physical-intuition/kimi-chip/dataflow/x3y5_timing/reports_final/cts_default_core_clock_layout.webp

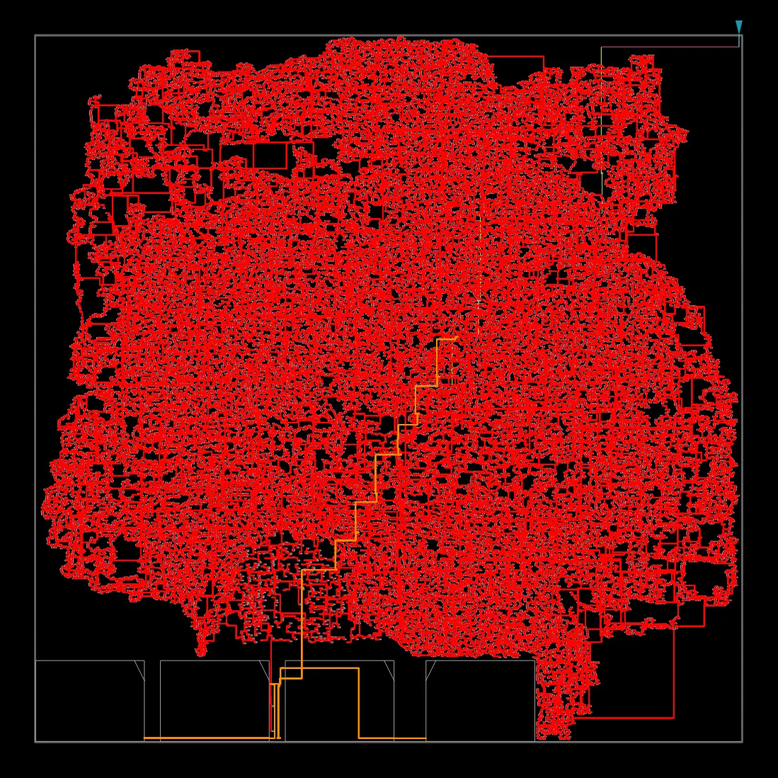
dataflow/x3y5_timing/reports_final/cts_default_core_clock_layout.webp
