physical-intuition/kimi-chip/dataflow/x3y5_timing/reports_final/final_resizer.webp

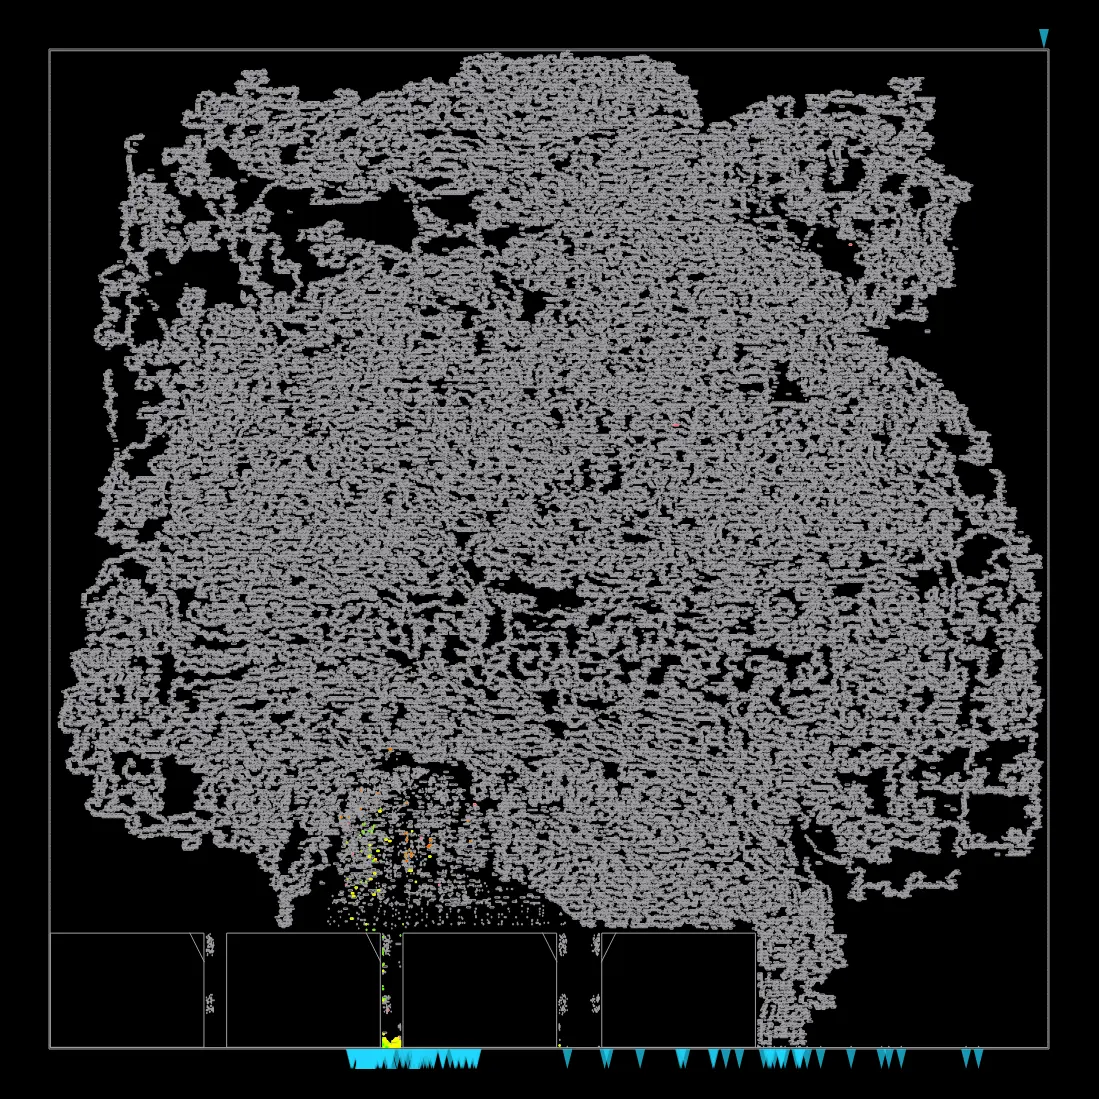
dataflow/x3y5_timing/reports_final/final_resizer.webp
