physical-intuition/kimi-chip/EXPERIMENTS.md

# kimi-chip-fresh dataflow experiment log

repo: github.com/physical-intuition/kimi-chip
flow: openroad/orfs:latest, nangate45, top = dataflow_top
dims (toy): D_MODEL=32, KDA 2x16, MLA dk16 dr8 dv16 dc32, MAX_SEQ=16, CONV_KERNEL=4, N_LAYERS=2
dims (real/nano-kpu): D_MODEL=64, KDA 2x32, MLA dc=128, MAX_SEQ=64

## X1: FSM skeleton (constraint sweep)
| variant | change | period (ns) | fmax (GHz) | setup ws (ns) | viol | area (um2) | power (mW) | commit |
|---|---|---|---|---|---|---|---|---|
| X1Y1 | FSM skeleton, all phases cycle-counting | 1.0 | 2.294 | - | 0 | ~591 | ~1.0 | 4ee46f1 |
| X1Y2 | constraint tighten | 0.8 | 2.289 | 0.363 | 0 | 591.1 | 1.08 | 618b87a |
| X1Y3 | constraint tighten | 0.6 | 2.317 | 0.168 | 0 | 591.9 | 1.42 | 2a0e823 |
| X1Y4 | constraint tighten | 0.5 | 2.295 | 0.064 | 0 | 592.6 | 1.71 | 9ede9e6 |
| X1Y5 | constraint tighten | 0.48 | 2.347 | 0.054 | 0 | 594.2 | 1.80 | 8a6d8e4 |

## X2: Add real compute (MAC + SRAM)
| variant | change | period (ns) | fmax (GHz) | setup ws (ns) | viol | area (um2) | power (mW) | commit |
|---|---|---|---|---|---|---|---|---|
| X2Y1 | MAC wired into KDA Q/K/V GEMV | 0.6 | 1.687 | 0.007 | 0 | 2234.9 | 3.06 | 9c45739 |
| X2Y2 | MAC into MLA attention (Q.K scores) | 0.6 | 0.876* | -0.542 | 64 | 88121 | 236.3 | 782889c |
| X2Y3 | KV cache -> fakeram45_512x64 SRAM | 0.6 | 0.899* | -0.512 | 272 | 106792 | 258.5 | 090f6f7 |
| X2Y4 | 2-stage pipelined MAC | 0.6 | 1.542* | -0.049 | 108 | 106473 | 264.6 | d52b302 |
| X2Y5 | + set_false_path rst_n | 0.6 | 1.643* | -0.0085 | 2 | 104496 | 254.8 | 1706a52 |

* violates setup timing

## learnings
- X1: FSM-only meets any constraint, sweep uninformative
- X2Y1: adding real GEMV found wall immediately (2.3 -> 1.687 GHz)
- X2Y7: MLA attention costs dearly (1.69 -> 0.876 GHz), KV cache area explodes 2.5k -> 88k um2
- X2Y10: SRAM alone does not fix it, MAC accumulator path exposed
- X2Y11: 2-stage MAC pipeline massive jump (0.899 -> 1.542 GHz)
- X2Y13/Y14: operand staging + reset false path -> 1.643 GHz champion
- X2Y15: true wall ~1.64 GHz at toy dims, argmax compare fanout is binding path

## known gaps vs nano-kpu
- dims 4x small (toy) vs real
- no INT4 group-128 dequant
- no functional/bit-exact verification vs golden model
- harness is still run OpenROAD, read timing without functional validation

## X3: Real dims + functional validation harness (pending)
- X3Y1: D_MODEL=64, dc=128, seq=64, running...
---

## ⚠️ CORRECTNESS STATUS UPDATE (Oct 23, 2026)

**X1Y1 through X3Y5: TIMING VALID, FUNCTIONALLY INVALID**

These iterations measured physical timing on incomplete datapath skeletons. The actual compute (KDA delta rule, MLA softmax/value/output, RMSNorm, MoE routing, residual mixing) was stub or missing. Timing results are real for the hardware that exists, but that hardware does not run full inference.

X4Y1 golden model harness exposed these gaps. X4Y2 fixed some bounds issues but full inference still fails.

**Valid functional work starts at X4Y3 with actual operator implementations.**

---

## X4: Golden-model functional correctness (harness 4)
Harness: RTL vs Python reference, cycle-by-cycle (golden.py) and exact per-tensor (operator models), strict inference gate that must fail until full inference exists. Normative spec: MoonshotAI/nano-kpu reference/model.py (vendored at third_party/nano-kpu, commit e1855de, SHA-256 pinned from X4Y4). Weights are synthetic throughout.
Directory note: dataflow/x4y4, x4y4_reports, x4y5*, x5y* are pre-scheme physical-flow runs (old numbering), not harness-4/5 iterations; they are not renumbered.

| variant | change | verification | result | dir | commit |
|---|---|---|---|---|---|
| X4Y1 | full-top arithmetic diagnostic + strict inference gate | golden.py cycle model | diagnostic match, strict fails (correctly) | x4y1_golden | 077c37d |
| X4Y2 | MLA cache bounds, backpressure until restart, projection storage overflow | + bounds/protocol tbs | pass, strict fails | x4y2_bounds | f9d340d |
| X4Y3 | KDA operators (proj, conv+SiLU, L2, gates, delta rule, gated norm, o-proj) | RTL == kda_model exact, 6 tok / 2 seq | exact, strict fails | x4y3_kda | 3e8f7c2 |
| X4Y4 | MLA operators (latent wc + knorm RMSNorm, q/kr from h, kc/v decompression, KV cache in 9x512x64 SRAM, NoPE scores, LUT softmax, p@V, o-proj); reference int4 dequant (z, Q3.12 s, group 128/64) with official seeded weights; KDA fixes (f/z rank 32, gated-norm eps 1e-5) | RTL == mla_model / kda_model exact on 6 tok, 66 tok (64-entry cache, refused 65th, restart), group 64; mla_model vs model.py `_mla` | exact; MLA out cos vs model.py >= 0.99965 (64-entry cache); strict fails (MLA input staged, no norm/MoE/residual/head) | x4y4_mla | bff9268 |
| X4Y5 | RMSNorm (norm1/norm2), attention-residual mixing (L0.res_mlp, L1.res_attn, L1.res_mlp), sigmoid-router top-2 MoE + shared expert on official int4 weights, residual adds: GLUE micro-program wires L0 KDA -> L1 MLA as RefModel.step (x0 to L1.out); per-vector exponents for KDA in / o_proj in / MLA in | RTL == decoder_model exact (every KDA/MLA/glue tensor + KV cache) on 6 tok, group 64, 66 tok (64-entry cache, refused 65th, restart); 13 mutations; decoder_model vs model.py RefModel.step (same staged x0) | exact; L0.out cos >= 0.9936, L1.out >= 0.9906 except 1 near-tie MoE top-2 flip (tok 339, key gap 6.4e-4, L1 cos 0.868, reported); strict fails (x0 staged, no res_out/final norm/head) | x4y5_norm_moe | a1fff91 |
| X4Y6 | official INT4 embedding ROM lookup (x0), final res_out mix [x0, L1.out], final RMSNorm, untied 64x512 LM head on the INT4 MAC (per-vector exp INT8 codes), real argmax (strict greater, lowest index) replacing token_id+1; strict gate now checks inference (public prompts, logits cos >= 0.98 every row vs RefModel, official weights) | RTL == decoder_model exact incl. 512 logits + argmax on 6 tok, group 64, 66 tok (cache full, refusal, restart), public prompts 48+16; 20 mutations; golden.py checks argmax port; logits cos vs RefModel (official, and with X4Y3 KDA placeholders) | exact; vs official ref min cos -0.35, argmax 3/64 (KDA placeholders) => strict fails; vs placeholder-KDA ref mean 0.991, min 0.677, 4/64 rows < 0.98 (all L1 MoE 2nd-expert flips, key gaps 3e-4..1.3e-2), 6/64 argmax flips; group 64 worse; 215.8k cyc/token | x4y6_head | 568f4ad |

### X4 learnings
- X4Y4: checking the X4Y3 KDA float model against model.py itself (not a re-derivation) exposed two structural deviations (rank 8 vs kda_dim 32, eps 1e-6 vs 1e-5; up to 155% of max|out| on early tokens) that an RTL==own-model exact match cannot see. From X4Y4 on, every operator is also compared to RefModel directly.
- X4Y4: MLA error vs reference is dominated by INT8 coding of lat/ctx at the MAC input, not by softmax (LUT < 1.5e-4) or the latent norm (cos > 0.99999).
- X4Y4: KDA fixed point is weak on the first token of a sequence (cos 0.983 vs model.py); revisit numerics before logits are judged.
- X4Y4: Icarus 13 rejects use-before-declaration; X4Y4 RTL is order-clean, frozen X4Y2/X4Y3 need Icarus <= 12.
- X4Y5: X4Y4's fixed KDA o_proj input exponent (e = 11) saturated once real normed activations flowed; per-vector exponents on every matmul input fixed it (first-token L0.out cos >= 0.991 vs X4Y4 KDA out 0.983).
- X4Y5: MoE top-k is discontinuous: a 6.4e-4 float key gap between experts 2 and 3 flips the second expert in fixed point and drops that token's L1.out cos to 0.868. Exact RTL == model cannot see this; only the RefModel comparison does. Flips are reported per token, with an explicit tie tolerance (2e-3), not averaged away. Judge at logits in X4Y6.
- X4Y5: GLUE adds ~41k cycles/token (182.5k total), almost all MoE projections at one MAC per cycle.
- X4Y6: first real logits. RTL == model exactness says nothing about inference: with matched weights the chip is 0.991 mean logits cosine, yet against the official weights it is uncorrelated, because L0 KDA still runs on X4Y3 placeholders. The strict gate now measures exactly this (model.py bar, every public-prompt row) instead of a fixed blocker list.
- X4Y6: the X4Y5 token-339 near-tie reaches the logits (P0 pos28, cos 0.677), but near-ties are not the whole problem: integer router keys err by up to ~0.03 from upstream INT8 coding, so 1e-2 gaps flip too (group 64: 0.039). A full-precision router on the integer h2 does not help; precision has to improve upstream of the router.
- Next: official L0.kda weights in RTL (reference int4 format, like MLA/MoE) so the strict gate can be judged on the real model, then reduce MoE selection flips (upstream activation precision); then X5 harness work (PPA of the correct design / workload power with switching activity).
