physical-intuition/kimi-chip/experiments/MATRIX_CONTINUATION_PROMPT.md

# Persistent 5x5 Kimi Matrix Continuation

You own the continuation of the 5×5 physical-design experiment in this checkout. Do not commit or push anything. This is an unattended but evidence-driven engineering run, so never invent a metric, terminal result, or validation.

Start by reading `experiments/KIMI_SPEC.md`, `experiments/5x5_status.json`, and all X1 files including `trials.jsonl`, `DESIGN_Y*.md`, RTL/testbenches/flow config and current remote logs. Current complete state is X1-Y1 through X1-Y4. X1-Y5 is remote and live on GCS host `kit@35.203.156.158`, SSH key `~/.ssh/gcs-vm`, tmux session `x1-y5-route`, Docker container `x1_y5_orfs`, log `/home/kit/kimi-chip/experiments/x1/build/orfs_y5.log`. That remote checkout is the canonical experimental working tree while ORFS routes are in flight.

X1 semantics are logging only. X2 must explicitly add lint rules for actual SRAM macro usage, accumulator overflow, and double-accumulation hazards. X3 must add locked functional regression tests and a failed-directions log. X4 and X5 must make genuinely system-discovered improvements from prior results, not cosmetic renamed copies. Each of Y1 through Y5 should be a distinct documented iteration that learns from the prior actual evidence, and each cell must run the real full Nangate45 ORFS flow remotely. Maintain functional 16×16 signed INT4 outer-product semantics with registered SRAM-read interface and test at K=7, K=0, K=13 back-to-back. Preserve strict signoff criteria: functional pass, final extracted setup/hold/slew/fanout/max-cap all zero violations, zero DRC, zero antenna. If any fails, mark it fail precisely and learn from it. Don’t optimize a metric by quietly dropping criteria.

Y5 local regressions already passed 768/768 K=7/0/13. When its remote flow terminates, capture raw reports before altering anything. Record it exactly once in `experiments/x1/trials.jsonl`, create `experiments/x1/DESIGN_Y5.md`, and update `experiments/5x5_status.json`. Use exact report-derived values only. Then create X2 through X5 experiments and execute one cell after the other. Put all local work under `experiments/xN`. Use remote tmux sessions and containers so active full flows survive your own terminal. Store each flow output in its cell build directory and save flow exit code. Update `5x5_status.json` before each launch and after each terminal result.

Use Python to parse reports into a consistent evidence summary if useful, but source all values from ORFS artifacts. First inspect what tool/image/version/config paths work from X1 and reuse them. Detect Y5 termination via `.y5_flow_rc`, container absence, and terminal `FLOW_RC`. Do not abort a healthy route prematurely. Persist enough current status in the JSON plus a short `experiments/MATRIX_PROGRESS.md` after every terminal cell so a future agent can resume. No Git operations that modify history or remote.

If a route dies because the host/container fails, preserve the failure evidence, log it, then recover/retry only when justified and keep the distinct cell record clear. Do not report intermediate routine status. Work until all 25 cells have terminal evidence, or if unable to continue, leave explicit exact blocker and current active remote session in status/progress.

## X4 harness and frequency-escalation protocol

This protocol supersedes the old constant-400 MHz approach for X4. Leave X3 on its existing methodology through Y5. Do not pre-plan, specify, or implement X5 yet. X5 must emerge only after all X4 evidence exists.

Before X4-Y1, read every entry in `experiments/x1/trials.jsonl`, `experiments/x2/trials.jsonl`, and `experiments/x3/trials.jsonl`, including both successes and failures. Build a machine-readable failure-pattern summary tied to raw artifacts. Extract recurring functional, timing, electrical, congestion, routing, and methodology failures. Write X4's initial lint rules from those observed patterns, with an evidence citation and executable check for each rule. Do not invent generic rules unsupported by X1-X3.

X4 must start from the proven v9/v10 hierarchical accumulator architecture, not the current wide per-cycle accumulator and not an unchanged RTL with a tighter clock. Read and reuse the actual implementation evidence in `rtl/int4_mac_v9.v`, `rtl/compute_core_v9.v`, `rtl/mac_array_v9.v`, the corresponding v10 files, and `tb/tb_v9_v10.v` before implementing X4-Y1.

The required arithmetic structure is a signed 12-bit partial/chunk accumulator on the per-cycle multiply-add path plus a signed 24-bit wide accumulator. Fold the 12-bit chunk into the 24-bit accumulator every 16 valid products and flush the final partial chunk before `done`. The 24-bit fold must occur on a separate register-to-register cycle with no multiplier in front of it. Preserve single-add semantics so each registered SRAM result is accumulated exactly once. This is the architectural optimization that previously achieved about 752 MHz versus the roughly 250 MHz wide-accumulator baseline.

The width proof is part of the design contract. For signed INT4, maximum absolute product is 64. Sixteen products require at most 1024 magnitude, which is safe in signed 12 bits. At the 16-bit interface maximum `k_dim=65535`, the worst positive sum is 4,194,240, which fits in signed 24 bits. Do not claim full-range support from width reasoning alone: add latency-aware functional checks across fold boundaries and an adversarial `K=65535` regression, including tail flush behavior, signed extrema, reset/restart, and exactly-once accumulation. Keep the existing K=7, K=0, and K=13 locked regressions too.

X4-Y1's target is 752 MHz, approximately a 1.33 ns clock period, using this hierarchical-fold architecture as the baseline. Y2 through Y5 must push monotonically above 752 MHz. Do not preselect arbitrary targets unsupported by data; after each final extracted report, choose and record the next higher target from achieved headroom and the exact failing path. Every later Y must make an evidence-driven RTL or physical-design improvement before raising the target. The previous 500/600/700/800/900 MHz ladder is superseded for X4 because it would waste iterations below the proven architectural baseline.

After every X4 Y run, automatically parse the actual synthesis and final extracted timing reports. Produce a structured timing analysis containing target period/frequency, achieved extracted fmax, WNS/TNS, violating endpoint count, worst startpoint and endpoint, path group, logic/cell sequence where available, combinational depth, high-fanout nets, transition/capacitance violations, congestion/routing evidence, and hold-repair side effects. Preserve the raw report path for every extracted fact.

Each Y after Y1 must be a genuine timing-closure iteration informed by the immediately preceding Y's parsed evidence. Do not merely tighten the SDC against unchanged RTL. Identify the worst paths and document a concrete proposed RTL repair before editing, such as adding a pipeline boundary, retiming state, registering request/readout boundaries, breaking mux or accumulation paths, reducing fanout, or restructuring decode. Apply justified physical-design changes only when supported by reports, such as utilization/density changes, timing-driven placement settings, repair margins, placement constraints, and buffer/fanout controls. Preserve the external module contract and signed INT4 mathematical result; update latency-aware locked regressions whenever latency changes.

When a run exposes a new bug or preventable structural pattern, add a new executable X4 lint rule before the next Y and record which run/report caused it. Keep rules cumulative unless evidence proves one harmful, in which case document its removal. Lint-rule discovery is part of the X4 harness result, not prose decoration.

For every cell, record both target frequency and achieved extracted fmax. Strict pass requires functional regression, target setup timing met, zero extracted setup/hold/slew/fanout/max-cap violations, zero DRC, and zero antenna violations. A completed full flow that misses its target is a valid terminal FAIL. Document exactly what broke, including WNS/TNS and the critical path, and state the specific RTL change most likely to fix it in the next Y. Never lower the target, reuse a lower-frequency report as success, or hide latency/throughput costs.

After X4-Y5 is terminal, stop before designing X5. Summarize X4's actual trajectory, learned lint rules, timing analyses, successful transforms, failed transforms, and remaining bottlenecks. Leave X5 pending so its harness design can be derived from this evidence rather than speculation.
