physical-intuition/kimi-chip/results/kimi_3d.png

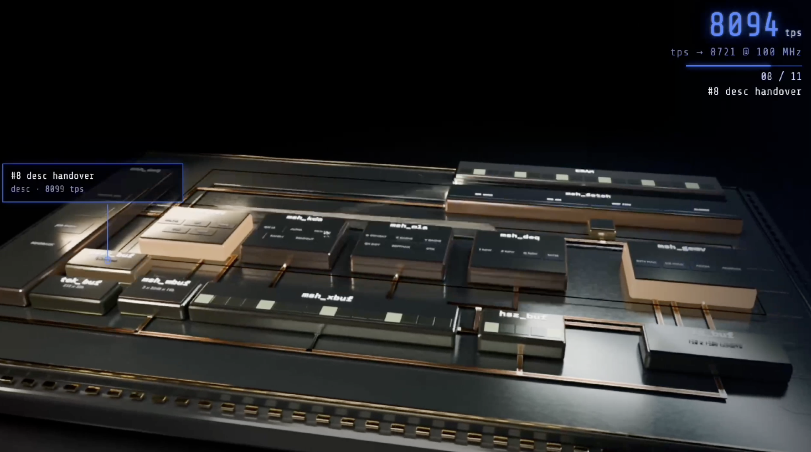
results/kimi_3d.png
