physical-intuition/kimi-chip/results/layout_3d.png

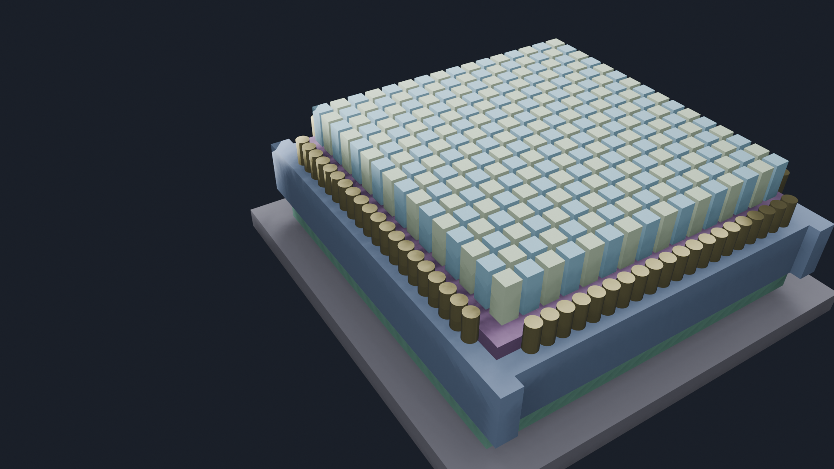
results/layout_3d.png
