physical-intuition/kimi-chip/results/layout_v4.png

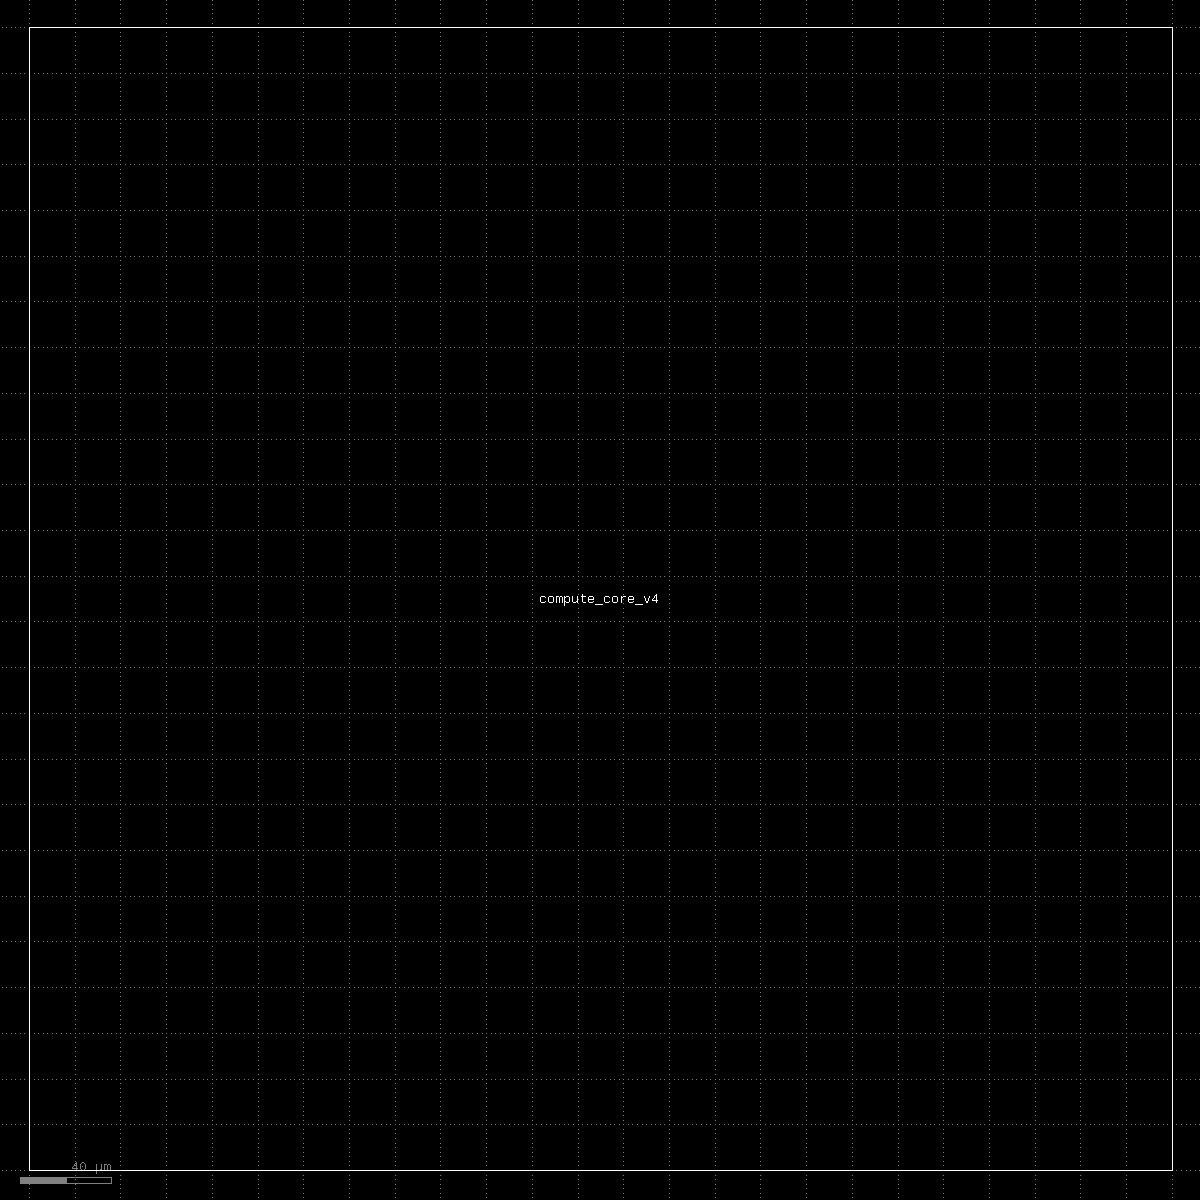
results/layout_v4.png
