physical-intuition/kimi-chip/results/layout_v4_color.png

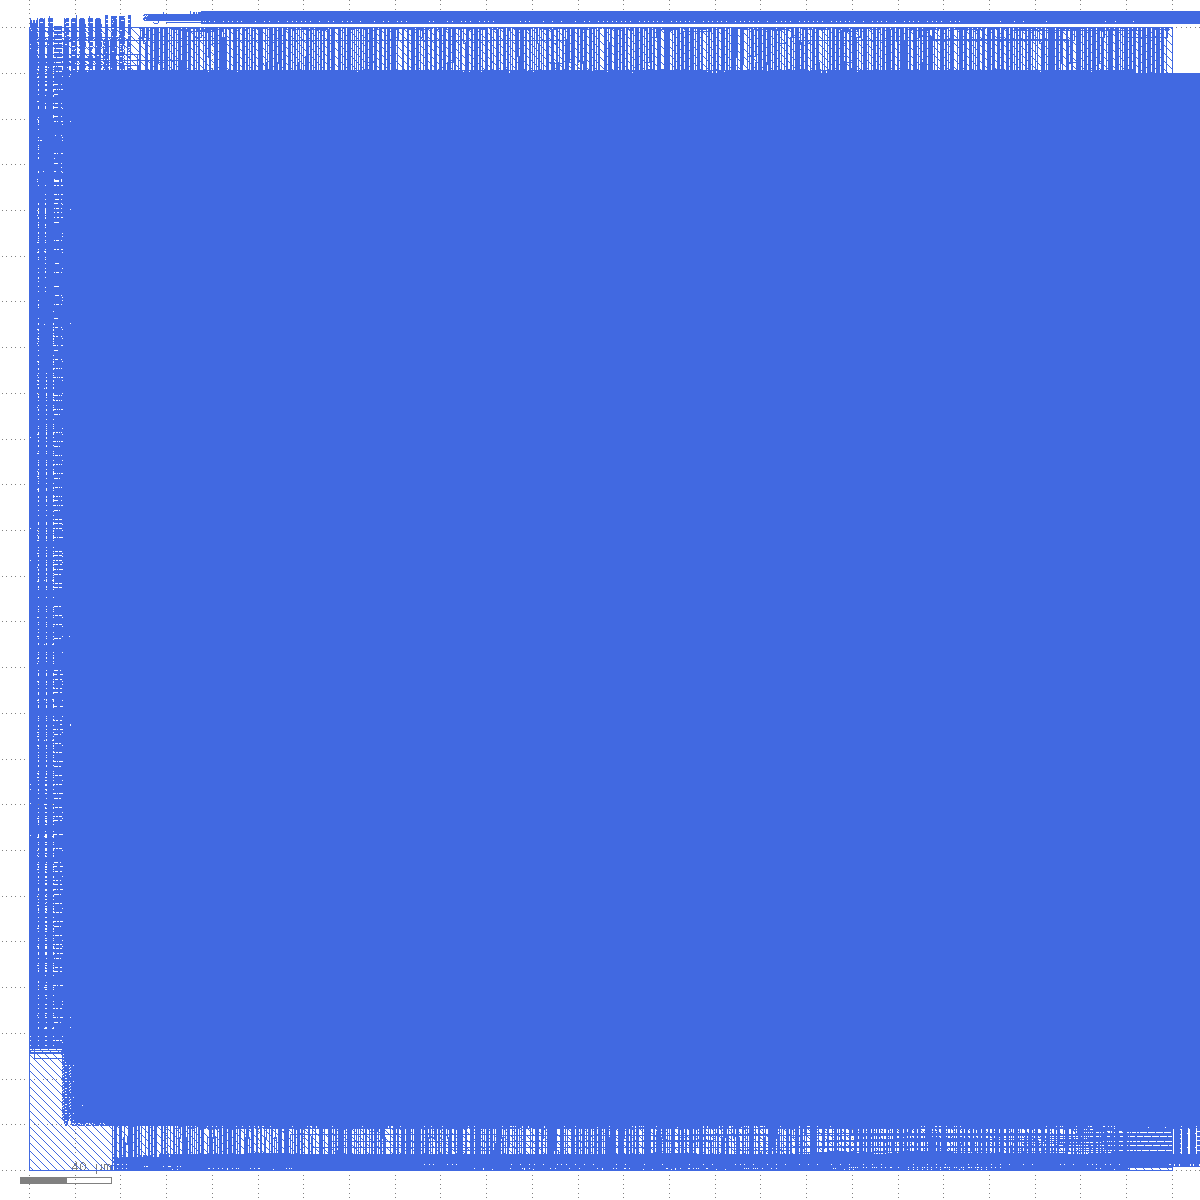
results/layout_v4_color.png
