physical-intuition/kimi-chip/results/layout_v4_nice.png

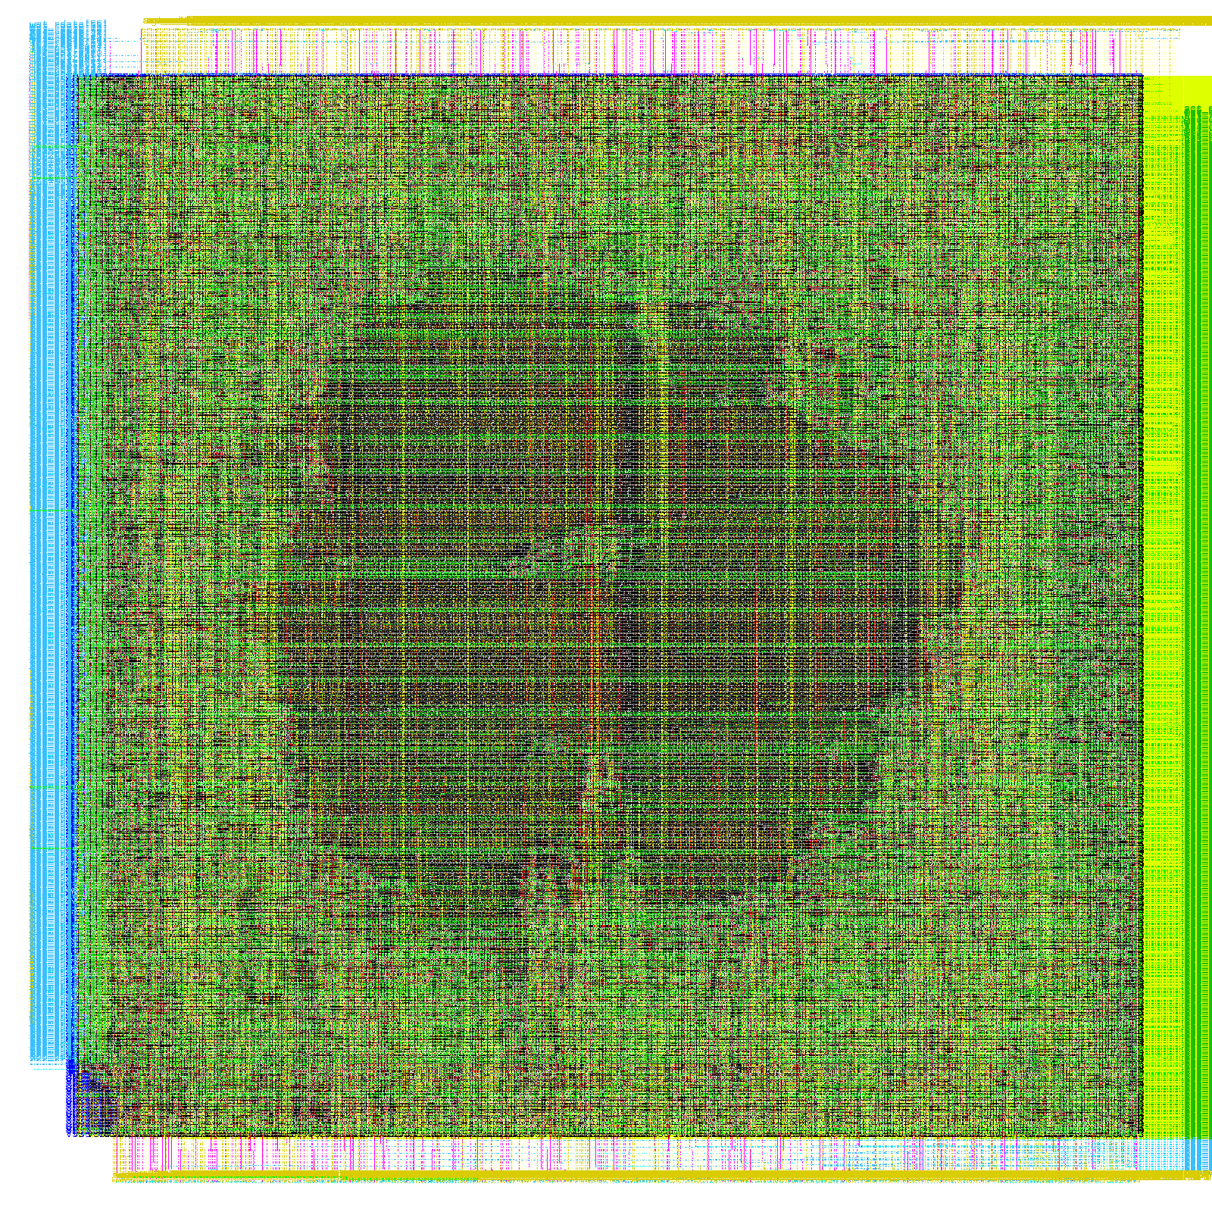
results/layout_v4_nice.png
