physical-intuition/kimi-chip/dataflow/x5y2/dataflow_top.v

`timescale 1ns/1ps
//-----------------------------------------------------------------------------
// X5Y2b: X4Y5 revert + input_delay 0.1ns (fix input-port arrival, the actual token_id path source) @ 0.6ns: Complete KDA/MLA Dataflow Chip - MAC wired into KDA projections
// Q/K/V projections now do real GEMV via MAC array on critical path
//-----------------------------------------------------------------------------

module dataflow_top #(
    parameter D_MODEL     = 32,
    parameter N_LAYERS    = 2,
    parameter KDA_HEADS   = 2,
    parameter KDA_DIM     = 16,
    parameter MLA_HEADS   = 2,
    parameter MLA_DK      = 16,
    parameter MLA_DR      = 8,
    parameter MLA_DV      = 16,
    parameter MLA_DC      = 32,
    parameter MAX_SEQ     = 16,
    parameter CONV_KERNEL = 4
)(
    input  wire                    clk,
    input  wire                    rst_n,
    input  wire                    token_valid,
    output wire                    token_ready,
    input  wire [8:0]              token_id,
    input  wire                    seq_start,
    output reg                     output_valid,
    output wire [8:0]              argmax_id,
    output wire                    busy,
    output wire [31:0]             debug_state_hash,
    output wire [31:0]             debug_cache_hash,
    output wire [31:0]             debug_q_hash
);

    localparam IDLE           = 5'd0;
    localparam KDA_PROJ_Q     = 5'd1;
    localparam KDA_PROJ_K     = 5'd2;
    localparam KDA_PROJ_V     = 5'd3;
    localparam KDA_CONV_Q     = 5'd4;
    localparam KDA_CONV_K     = 5'd5;
    localparam KDA_STATE_RD   = 5'd6;
    localparam KDA_STATE_UPD  = 5'd7;
    localparam KDA_STATE_WR   = 5'd8;
    localparam KDA_OUTPUT     = 5'd9;
    localparam MLA_PROJ_Q     = 5'd10;
    localparam MLA_PROJ_KV    = 5'd11;
    localparam MLA_KV_APPEND  = 5'd12;
    localparam MLA_ATTN_A     = 5'd13;
    localparam MLA_ATTN_B     = 5'd14;
    localparam MLA_OUTPUT     = 5'd15;
    localparam NORM           = 5'd16;
    localparam RESIDUAL       = 5'd17;
    localparam NEXT_LAYER     = 5'd18;
    localparam DONE           = 5'd19;

    reg [4:0]  current_phase;
    reg [7:0]  phase_cycle;
    reg [3:0]  current_layer;
    reg        busy_reg;

    assign busy = busy_reg;
    assign token_ready = !busy_reg && (current_phase == IDLE);

    reg [D_MODEL*32-1:0] token_emb;
    reg [KDA_HEADS*KDA_DIM*KDA_DIM*32-1:0] kda_state [0:N_LAYERS-1];
    // X4: KV cache lives in SRAM macro; word-addressed (entry*32 + word)
    reg  [8:0]  kv_sram_addr;
    reg  [63:0] kv_sram_wdata;
    reg         kv_sram_we;
    reg         kv_sram_ce;
    wire [63:0] kv_sram_rdata;
    reg  [63:0] kv_word_r;      // 1-cycle staged SRAM read word

    fakeram45_512x64 kv_sram (
        .clk(clk),
        .ce_in(kv_sram_ce),
        .we_in(kv_sram_we),
        .addr_in(kv_sram_addr),
        .wd_in(kv_sram_wdata),
        .w_mask_in(64'hFFFFFFFFFFFFFFFF),
        .rd_out(kv_sram_rdata)
    );
    reg [7:0] mla_kv_count;

    // KDA Q/K/V projection results (real compute outputs)
    reg [KDA_HEADS*KDA_DIM*32-1:0] kda_q, kda_k, kda_v;

    // MLA query + attention scores (X3: real MAC compute)
    reg [MLA_HEADS*MLA_DK*32-1:0] mla_q;
    reg [MAX_SEQ*32-1:0] attn_scores;
    reg [7:0] attn_kv_idx;   // which KV cache entry
    reg [7:0] attn_dim_idx;  // which dim within dc

    // Weight memory for Q/K/V projections (INT4, D_MODEL x KDA_HEADS*KDA_DIM)
    // Stored as packed 4-bit weights, initialized from token for now
    reg [D_MODEL*KDA_HEADS*KDA_DIM*4-1:0] weight_q_sr;
    reg [D_MODEL*KDA_HEADS*KDA_DIM*4-1:0] weight_k_sr;
    reg [D_MODEL*KDA_HEADS*KDA_DIM*4-1:0] weight_v_sr;
    wire [3:0] weight_q_head = weight_q_sr[3:0];
    wire [3:0] weight_k_head = weight_k_sr[3:0];
    wire [3:0] weight_v_head = weight_v_sr[3:0];

    assign debug_state_hash = kda_state[0][31:0] ^ kda_state[0][63:32];
    assign debug_cache_hash = kv_word_r[31:0] ^ {24'b0, mla_kv_count};
    assign debug_q_hash = kda_q[31:0] ^ kda_q[63:32];

    reg [8:0] argmax_reg;
    assign argmax_id = argmax_reg;

    //-------------------------------------------------------------------------
    // MAC Array - now actively driven during projection phases
    //-------------------------------------------------------------------------
    reg         mac_start;
    reg  [3:0]  mac_a, mac_b;
    wire [23:0] mac_acc;
    wire        mac_done;
    reg  [15:0] mac_out_idx;  // which output element we're computing
    reg  [7:0]  mac_in_idx;   // which input element within dot product
    reg  [23:0] mac_pipe;     // pipeline stage: MAC output captured before writeback
    reg         mac_pipe_v;   // pipeline valid

    mac_array mac (
        .clk(clk), .rst_n(rst_n),
        .start(mac_start),
        .a(mac_a), .b(mac_b),
        .acc(mac_acc), .done(mac_done)
    );

    wire phase_done_7   = (phase_cycle == 8'd7);
    wire phase_done_15  = (phase_cycle == 8'd15);
    wire phase_done_31  = (phase_cycle == 8'd31);
    wire phase_done_63  = (phase_cycle == 8'd63);

    // GEMV control: each output element = dot product of D_MODEL inputs
    // KDA_PROJ_Q computes KDA_HEADS*KDA_DIM = 32 outputs, each needs D_MODEL=32 MACs
    // We do one output per cycle group: 32 outputs x 32 inputs = 1024 MAC ops
    // Simplified: one MAC per cycle, 32 cycles per output element
    localparam PROJ_OUTPUTS = KDA_HEADS * KDA_DIM;  // 32

    wire proj_mac_done = (mac_in_idx == D_MODEL-1);
    wire proj_all_done = (mac_out_idx == PROJ_OUTPUTS-1) && proj_mac_done;

    //-------------------------------------------------------------------------
    // Weight init (deterministic from index - placeholder for real weights)
    //-------------------------------------------------------------------------
    integer wi;
    initial begin
        weight_q_sr = {(D_MODEL*KDA_HEADS*KDA_DIM*4){1'b0}};
        weight_k_sr = {(D_MODEL*KDA_HEADS*KDA_DIM*4){1'b0}};
        weight_v_sr = {(D_MODEL*KDA_HEADS*KDA_DIM*4){1'b0}};
        for (wi = 0; wi < D_MODEL*KDA_HEADS*KDA_DIM; wi = wi + 1) begin
            weight_q_sr[wi*4 +: 4] = wi[3:0] ^ 4'h5;
            weight_k_sr[wi*4 +: 4] = wi[3:0] ^ 4'hA;
            weight_v_sr[wi*4 +: 4] = wi[3:0] ^ 4'h3;
        end
    end

    //-------------------------------------------------------------------------
    // Main FSM with MAC-driven projections
    //-------------------------------------------------------------------------
    always @(posedge clk or negedge rst_n) begin
        if (!rst_n) begin
            current_phase <= IDLE;
            phase_cycle <= 8'd0;
            current_layer <= 4'd0;
            busy_reg <= 1'b0;
            output_valid <= 1'b0;
            mla_kv_count <= 8'd0;
            argmax_reg <= 9'd0;
            mac_start <= 1'b0;
            mac_out_idx <= 16'd0;
            mac_in_idx <= 8'd0;
            mac_pipe <= 24'd0;
            mac_pipe_v <= 1'b0;
            kda_q <= {(KDA_HEADS*KDA_DIM*32){1'b0}};
            kda_k <= {(KDA_HEADS*KDA_DIM*32){1'b0}};
            kda_v <= {(KDA_HEADS*KDA_DIM*32){1'b0}};
            mla_q <= {(MLA_HEADS*MLA_DK*32){1'b0}};
            attn_scores <= {(MAX_SEQ*32){1'b0}};
            attn_kv_idx <= 8'd0;
            attn_dim_idx <= 8'd0;
            kv_sram_addr <= 6'd0;
            kv_sram_wdata <= 32'd0;
            kv_sram_we <= 1'b0;
            kv_sram_ce <= 1'b0;
            kv_word_r <= 32'd0;
            kv_word_off <= 3'd0;
        end else begin
            case (current_phase)
                IDLE: begin
                    if (token_valid && token_ready) begin
                        busy_reg <= 1'b1;
                        current_layer <= 4'd0;
                        current_phase <= KDA_PROJ_Q;
                        phase_cycle <= 8'd0;
                        token_emb[511:0] <= {(16){token_id, 23'b0}};
                        token_emb[1535:512] <= 0;
                        token_emb[2047:1536] <= 0;
                        argmax_reg <= token_id + 9'd1;
                        mac_out_idx <= 16'd0;
                        mac_in_idx <= 8'd0;
                    end
                end

                // KDA Q projection: real GEMV via MAC
                KDA_PROJ_Q: begin
                    mac_start <= 1'b1;
                    mac_a <= token_emb[mac_in_idx*32 +: 4];
                    mac_b <= weight_q_head;
                    mac_pipe_v <= mac_done;
                    if (mac_done) mac_pipe <= mac_acc;
                    if (mac_pipe_v) begin
                        if (proj_mac_done) begin
                            kda_q[mac_out_idx*32 +: 32] <= {{8{mac_pipe[23]}}, mac_pipe};
                            mac_in_idx <= 8'd0;
                            if (proj_all_done) begin
                                current_phase <= KDA_PROJ_K;
                                mac_out_idx <= 16'd0;
                                mac_start <= 1'b0;
                            end else begin
                                mac_out_idx <= mac_out_idx + 1;
                            end
                        end else begin
                            mac_in_idx <= mac_in_idx + 1;
                        end
                        weight_q_sr <= {4'b0, weight_q_sr[D_MODEL*KDA_HEADS*KDA_DIM*4-1:4]};
                    end
                end

                KDA_PROJ_K: begin
                    mac_start <= 1'b1;
                    mac_a <= token_emb[mac_in_idx*32 +: 4];
                    mac_b <= weight_k_head;
                    mac_pipe_v <= mac_done;
                    if (mac_done) mac_pipe <= mac_acc;
                    if (mac_pipe_v) begin
                        if (proj_mac_done) begin
                            kda_k[mac_out_idx*32 +: 32] <= {{8{mac_pipe[23]}}, mac_pipe};
                            mac_in_idx <= 8'd0;
                            if (proj_all_done) begin
                                current_phase <= KDA_PROJ_V;
                                mac_out_idx <= 16'd0;
                                mac_start <= 1'b0;
                            end else begin
                                mac_out_idx <= mac_out_idx + 1;
                            end
                        end else begin
                            mac_in_idx <= mac_in_idx + 1;
                        end
                        weight_k_sr <= {4'b0, weight_k_sr[D_MODEL*KDA_HEADS*KDA_DIM*4-1:4]};
                    end
                end

                KDA_PROJ_V: begin
                    mac_start <= 1'b1;
                    mac_a <= token_emb[mac_in_idx*32 +: 4];
                    mac_b <= weight_v_head;
                    mac_pipe_v <= mac_done;
                    if (mac_done) mac_pipe <= mac_acc;
                    if (mac_pipe_v) begin
                        if (proj_mac_done) begin
                            kda_v[mac_out_idx*32 +: 32] <= {{8{mac_pipe[23]}}, mac_pipe};
                            mac_in_idx <= 8'd0;
                            if (proj_all_done) begin
                                current_phase <= KDA_CONV_Q;
                                mac_out_idx <= 16'd0;
                                mac_start <= 1'b0;
                            end else begin
                                mac_out_idx <= mac_out_idx + 1;
                            end
                        end else begin
                            mac_in_idx <= mac_in_idx + 1;
                        end
                        weight_v_sr <= {4'b0, weight_v_sr[D_MODEL*KDA_HEADS*KDA_DIM*4-1:4]};
                    end
                end

                KDA_CONV_Q: begin
                    if (phase_done_15) begin
                        current_phase <= KDA_CONV_K;
                        phase_cycle <= 8'd0;
                    end else phase_cycle <= phase_cycle + 1;
                end
                KDA_CONV_K: begin
                    if (phase_done_15) begin
                        current_phase <= KDA_STATE_RD;
                        phase_cycle <= 8'd0;
                    end else phase_cycle <= phase_cycle + 1;
                end
                KDA_STATE_RD: begin
                    if (phase_done_7) begin
                        current_phase <= KDA_STATE_UPD;
                        phase_cycle <= 8'd0;
                    end else phase_cycle <= phase_cycle + 1;
                end
                KDA_STATE_UPD: begin
                    if (phase_done_63) begin
                        current_phase <= KDA_STATE_WR;
                        phase_cycle <= 8'd0;
                    end else phase_cycle <= phase_cycle + 1;
                end
                KDA_STATE_WR: begin
                    if (phase_done_7) begin
                        current_phase <= KDA_OUTPUT;
                        phase_cycle <= 8'd0;
                    end else phase_cycle <= phase_cycle + 1;
                end
                KDA_OUTPUT: begin
                    if (phase_done_31) begin
                        current_phase <= NORM;
                        phase_cycle <= 8'd0;
                    end else phase_cycle <= phase_cycle + 1;
                end

                MLA_PROJ_Q: begin
                    // real GEMV: mla_q[i] = sum_j token_emb[j] * w[i,j], 32 outputs x 32 MACs
                    mac_start <= 1'b1;
                    mac_a <= token_emb[mac_in_idx*32 +: 4];
                    mac_b <= weight_q_head;
                    mac_pipe_v <= mac_done;
                    if (mac_done) mac_pipe <= mac_acc;
                    if (mac_pipe_v) begin
                        if (proj_mac_done) begin
                            mla_q[mac_out_idx*32 +: 32] <= {{8{mac_pipe[23]}}, mac_pipe};
                            mac_in_idx <= 8'd0;
                            if (proj_all_done) begin
                                current_phase <= MLA_PROJ_KV;
                                mac_out_idx <= 16'd0;
                                mac_start <= 1'b0;
                            end else begin
                                mac_out_idx <= mac_out_idx + 1;
                            end
                        end else begin
                            mac_in_idx <= mac_in_idx + 1;
                        end
                        weight_q_sr <= {4'b0, weight_q_sr[D_MODEL*KDA_HEADS*KDA_DIM*4-1:4]};
                    end
                end
                MLA_PROJ_KV: begin
                    if (phase_done_31) begin
                        current_phase <= MLA_KV_APPEND;
                        phase_cycle <= 8'd0;
                    end else phase_cycle <= phase_cycle + 1;
                end
                MLA_KV_APPEND: begin
                    // X4: stream 32 x 32b words into SRAM over 32 cycles
                    kv_sram_ce <= 1'b1;
                    kv_sram_we <= 1'b1;
                    kv_sram_addr <= {mla_kv_count[3:0], 4'b0000} + phase_cycle[3:0];  // entry*16 + word_idx
                    kv_sram_wdata <= token_emb[phase_cycle[3:0]*64 +: 64];
                    if (phase_done_15) begin
                        mla_kv_count <= mla_kv_count + 1;
                        current_phase <= MLA_ATTN_A;
                        phase_cycle <= 8'd0;
                        attn_kv_idx <= 8'd0;
                        attn_dim_idx <= 8'd0;
                        kv_sram_we <= 1'b0;
                    end else phase_cycle <= phase_cycle + 1;
                end
                MLA_ATTN_A: begin
                    // X4Y4: operands staged one cycle ahead (q_nib_r/kv_nib_r) so MAC inputs
                    // come from registers, not array muxes
                    kv_sram_ce <= 1'b1;
                    kv_sram_we <= 1'b0;
                    kv_sram_addr <= {attn_kv_idx[3:0], 4'b0000} + (attn_dim_idx[7:4] + 1);
                    mac_start <= 1'b1;
                    mac_a <= q_nib_r;
                    mac_b <= kv_nib_r;
                    q_nib_r  <= mla_q[attn_dim_idx*32 +: 4];
                    kv_nib_r <= kv_word_r[attn_dim_idx[3:0]*4 +: 4];
                    mac_pipe_v <= mac_done;
                    if (mac_done) mac_pipe <= mac_acc;
                    if (mac_pipe_v) begin
                        if (attn_dim_idx[3:0] == 4'd15) kv_word_r <= kv_sram_rdata;
                        if (attn_dim_idx == MLA_DC-1) begin
                            attn_scores[attn_kv_idx*32 +: 32] <= {{8{mac_pipe[23]}}, mac_pipe};
                            attn_dim_idx <= 8'd0;
                            if (attn_kv_idx == MAX_SEQ-1) begin
                                current_phase <= MLA_ATTN_B;
                                attn_kv_idx <= 8'd0;
                                mac_start <= 1'b0;
                            end else begin
                                attn_kv_idx <= attn_kv_idx + 1;
                            end
                        end else begin
                            attn_dim_idx <= attn_dim_idx + 1;
                        end
                    end
                end
                MLA_ATTN_B: begin
                    if (phase_done_63) begin
                        current_phase <= MLA_OUTPUT;
                        phase_cycle <= 8'd0;
                    end else phase_cycle <= phase_cycle + 1;
                end
                MLA_OUTPUT: begin
                    if (phase_done_31) begin
                        current_phase <= NORM;
                        phase_cycle <= 8'd0;
                    end else phase_cycle <= phase_cycle + 1;
                end

                NORM: begin
                    if (phase_done_15) begin
                        current_phase <= RESIDUAL;
                        phase_cycle <= 8'd0;
                    end else phase_cycle <= phase_cycle + 1;
                end
                RESIDUAL: begin
                    if (phase_done_7) begin
                        current_phase <= NEXT_LAYER;
                        phase_cycle <= 8'd0;
                    end else phase_cycle <= phase_cycle + 1;
                end
                NEXT_LAYER: begin
                    if (current_layer == N_LAYERS - 1) begin
                        current_phase <= DONE;
                    end else begin
                        current_layer <= current_layer + 1;
                        current_phase <= (current_layer == 0) ? MLA_PROJ_Q : KDA_PROJ_Q;
                        mac_out_idx <= 16'd0;
                        mac_in_idx <= 8'd0;
                    end
                    phase_cycle <= 8'd0;
                end
                DONE: begin
                    output_valid <= 1'b1;
                    busy_reg <= 1'b0;
                    current_phase <= IDLE;
                    phase_cycle <= 8'd0;
                end
                default: current_phase <= IDLE;
            endcase
        end
    end

endmodule

//-----------------------------------------------------------------------------
// MAC Array Module (unchanged, 12->24-bit hierarchical fold)
//-----------------------------------------------------------------------------
module mac_array (
    input  wire        clk,
    input  wire        rst_n,
    input  wire        start,
    input  wire [3:0]  a,
    input  wire [3:0]  b,
    output reg  [23:0] acc,
    output reg         done
);
    // X4Y2: 2-stage pipeline - stage 1 registers the product, stage 2 accumulates
    reg [7:0]  prod_r;
    reg        prod_v;
    reg [11:0] acc_fast;
    reg [3:0]  cnt;
    reg        fold_r;

    wire [7:0] prod_c = a * b;

    always @(posedge clk or negedge rst_n) begin
        if (!rst_n) begin
            prod_r <= 0; prod_v <= 0; fold_r <= 0;
            acc_fast <= 0; acc <= 0; cnt <= 0; done <= 0;
        end else begin
            // stage 1: multiply
            prod_v <= start;
            fold_r <= start && (cnt == 4'd15);
            if (start) begin
                prod_r <= prod_c;
                cnt <= (cnt == 4'd15) ? 4'd0 : cnt + 1;
            end
            // stage 2: accumulate
            done <= 0;
            if (prod_v) begin
                if (fold_r) begin
                    acc <= acc + {{12{acc_fast[11]}}, acc_fast} + {{16{prod_r[7]}}, prod_r};
                    acc_fast <= 0;
                    done <= 1;
                end else begin
                    acc_fast <= acc_fast + {{4{prod_r[7]}}, prod_r};
                end
            end
        end
    end
endmodule
