physical-intuition/kimi-chip/dataflow/x4y2_bounds/kv_banked_2048x64.v

// Four physical 512x64 macros. Bank select follows synchronous read latency.
module kv_banked_2048x64 (
 input wire clk, ce_in, we_in,
 input wire [10:0] addr_in,
 input wire [63:0] wd_in, w_mask_in,
 output wire [63:0] rd_out
);
 reg [1:0] read_bank;
 wire [63:0] rdata [0:3];
 always @(posedge clk) if (ce_in) read_bank <= addr_in[10:9];
 genvar b;
 generate for (b=0;b<4;b=b+1) begin: banks
   fakeram45_512x64 ram(
     .clk(clk), .ce_in(ce_in && (addr_in[10:9] == b)),
     .we_in(we_in), .addr_in(addr_in[8:0]),
     .wd_in(wd_in), .w_mask_in(w_mask_in), .rd_out(rdata[b]));
 end endgenerate
 assign rd_out = rdata[read_bank];
endmodule
