physical-intuition/kimi-chip/rtl/compute_core_v3_pipe.v

module compute_core_v3 (
    input wire clk,
    input wire rst_n,
    input wire start,
    input wire [7:0] k_dim,
    output reg wgt_cs,
    output reg [9:0] wgt_addr,
    input wire [63:0] wgt_rdata,
    output reg act_cs,
    output reg [9:0] act_addr,
    input wire [63:0] act_rdata,
    output wire [256*16-1:0] acc_out,
    output reg done
);
    localparam IDLE=0, CLEAR=1, FETCH=2, COMPUTE=3, DRAIN=4, DONE=5;
    reg [2:0] state;
    reg [7:0] k_cnt;
    reg mac_en, mac_clear;
    
    mac_array_v3 #(.ROWS(16), .COLS(16), .ACC_WIDTH(16)) array (
        .clk(clk), .rst_n(rst_n),
        .en(mac_en), .clear(mac_clear),
        .activations(act_rdata),
        .weights(wgt_rdata),
        .acc_out(acc_out)
    );
    
    always @(posedge clk or negedge rst_n) begin
        if (!rst_n) begin
            state <= IDLE; k_cnt <= 0; done <= 0;
            mac_en <= 0; mac_clear <= 0;
            wgt_cs <= 0; act_cs <= 0;
            wgt_addr <= 0; act_addr <= 0;
        end else case (state)
            IDLE: if (start) begin state <= CLEAR; mac_clear <= 1; end
            CLEAR: begin mac_clear <= 0; state <= FETCH; k_cnt <= 0; end
            FETCH: begin
                wgt_cs <= 1; act_cs <= 1;
                wgt_addr <= k_cnt; act_addr <= k_cnt;
                state <= COMPUTE;
            end
            COMPUTE: begin
                mac_en <= 1;
                if (k_cnt == k_dim - 1) begin
                    state <= DRAIN;
                end else begin
                    k_cnt <= k_cnt + 1;
                    state <= FETCH;
                end
            end
            DRAIN: begin  // Wait 2 cycles for pipeline to drain
                mac_en <= 0;
                state <= DONE;
            end
            DONE: begin done <= 1; wgt_cs <= 0; act_cs <= 0; end
        endcase
    end
endmodule
