physical-intuition/kimi-chip/rtl/mac_array_v3_pipe.v

module mac_array_v3 #(
    parameter ROWS = 16,
    parameter COLS = 16,
    parameter ACC_WIDTH = 16
)(
    input wire clk,
    input wire rst_n,
    input wire en,
    input wire clear,
    input wire signed [ROWS*4-1:0] activations,
    input wire signed [COLS*4-1:0] weights,
    output wire signed [ROWS*COLS*ACC_WIDTH-1:0] acc_out
);
    genvar r, c;
    generate
        for (r = 0; r < ROWS; r = r + 1) begin : row
            for (c = 0; c < COLS; c = c + 1) begin : col
                int4_mac_v3 #(.ACC_WIDTH(ACC_WIDTH)) mac (
                    .clk(clk),
                    .rst_n(rst_n),
                    .en(en),
                    .clear(clear),
                    .a(activations[r*4 +: 4]),
                    .b(weights[c*4 +: 4]),
                    .acc(acc_out[(r*COLS + c)*ACC_WIDTH +: ACC_WIDTH])
                );
            end
        end
    endgenerate
endmodule
