physical-intuition/kimi-chip/experiments/x4/rtl/x4_y1_kimi.v

`timescale 1ns/1ps

// X4-Y1: v9/v10-derived hierarchical accumulation baseline.
// The multiply path updates only a signed 12-bit chunk. Every 16 valid
// products, a separate FOLD cycle transfers that chunk into a signed 24-bit
// accumulator. This keeps the 24-bit carry chain out of the per-product path.
module x4_y1_kimi (
    input  wire         clk,
    input  wire         rst_n,
    input  wire         start,
    input  wire [15:0]  k_dim,
    output reg          act_req,
    output reg  [15:0]  act_addr,
    input  wire [63:0]  act_rdata,
    output reg          weight_req,
    output reg  [15:0]  weight_addr,
    input  wire [63:0]  weight_rdata,
    output reg          out_we,
    output reg  [13:0]  out_addr,
    output reg  [23:0]  out_wdata,
    output wire         busy,
    output reg          done
);
    localparam S_IDLE  = 3'd0;
    localparam S_REQ   = 3'd1;
    localparam S_ACCUM = 3'd2;
    localparam S_FOLD  = 3'd3;
    localparam S_DRAIN = 3'd4;

    reg [2:0] state;
    reg [15:0] k_dim_q;
    reg [15:0] issued;
    reg [15:0] consumed;
    reg [4:0] chunk_count;
    reg fold_finishes_run;
    reg [3:0] drain_row, drain_col;

    reg signed [11:0] chunk_accum [0:15][0:15];
    reg signed [23:0] wide_accum  [0:15][0:15];

    genvar gr, gc;

    assign busy = (state != S_IDLE);

    always @* begin
        act_req = 1'b0;
        weight_req = 1'b0;
        act_addr = issued;
        weight_addr = issued;
        if (state == S_REQ && issued < k_dim_q) begin
            act_req = 1'b1;
            weight_req = 1'b1;
        end
    end

    always @(posedge clk or negedge rst_n) begin
        if (!rst_n) begin
            state <= S_IDLE;
            k_dim_q <= 16'd0;
            issued <= 16'd0;
            consumed <= 16'd0;
            chunk_count <= 5'd0;
            fold_finishes_run <= 1'b0;
            drain_row <= 4'd0;
            drain_col <= 4'd0;
            out_we <= 1'b0;
            out_addr <= 14'd0;
            out_wdata <= 24'd0;
            done <= 1'b0;
        end else begin
            out_we <= 1'b0;
            done <= 1'b0;
            case (state)
                S_IDLE: if (start) begin
                    k_dim_q <= k_dim;
                    issued <= 16'd0;
                    consumed <= 16'd0;
                    chunk_count <= 5'd0;
                    fold_finishes_run <= 1'b0;
                    drain_row <= 4'd0;
                    drain_col <= 4'd0;
                    state <= (k_dim == 0) ? S_DRAIN : S_REQ;
                end
                S_REQ: begin
                    issued <= issued + 1'b1;
                    state <= S_ACCUM;
                end
                S_ACCUM: begin
                    consumed <= consumed + 1'b1;
                    if ((chunk_count == 5'd15) || (consumed + 1'b1 == k_dim_q)) begin
                        fold_finishes_run <= (consumed + 1'b1 == k_dim_q);
                        chunk_count <= 5'd0;
                        state <= S_FOLD;
                    end else begin
                        chunk_count <= chunk_count + 1'b1;
                        state <= S_REQ;
                    end
                end
                S_FOLD: begin
                    if (fold_finishes_run) begin
                        drain_row <= 4'd0;
                        drain_col <= 4'd0;
                        state <= S_DRAIN;
                    end else begin
                        state <= S_REQ;
                    end
                end
                S_DRAIN: begin
                    out_we <= 1'b1;
                    out_addr <= {6'd0, drain_row, drain_col};
                    case (drain_row)
                        4'd0: out_wdata <= wide_accum[0][drain_col];
                        4'd1: out_wdata <= wide_accum[1][drain_col];
                        4'd2: out_wdata <= wide_accum[2][drain_col];
                        4'd3: out_wdata <= wide_accum[3][drain_col];
                        4'd4: out_wdata <= wide_accum[4][drain_col];
                        4'd5: out_wdata <= wide_accum[5][drain_col];
                        4'd6: out_wdata <= wide_accum[6][drain_col];
                        4'd7: out_wdata <= wide_accum[7][drain_col];
                        4'd8: out_wdata <= wide_accum[8][drain_col];
                        4'd9: out_wdata <= wide_accum[9][drain_col];
                        4'd10: out_wdata <= wide_accum[10][drain_col];
                        4'd11: out_wdata <= wide_accum[11][drain_col];
                        4'd12: out_wdata <= wide_accum[12][drain_col];
                        4'd13: out_wdata <= wide_accum[13][drain_col];
                        4'd14: out_wdata <= wide_accum[14][drain_col];
                        default: out_wdata <= wide_accum[15][drain_col];
                    endcase
                    if (drain_col == 4'd15) begin
                        drain_col <= 4'd0;
                        if (drain_row == 4'd15) begin
                            state <= S_IDLE;
                            done <= 1'b1;
                        end else drain_row <= drain_row + 1'b1;
                    end else drain_col <= drain_col + 1'b1;
                end
                default: state <= S_IDLE;
            endcase
        end
    end

    // Resetless datapath storage avoids a reset tree across 9216 accumulator
    // bits. Every accepted operation synchronously initializes all cells.
    generate
        for (gr = 0; gr < 16; gr = gr + 1) begin : g_row
            for (gc = 0; gc < 16; gc = gc + 1) begin : g_col
                wire signed [3:0] a_lane = act_rdata[gr*4 +: 4];
                wire signed [3:0] w_lane = weight_rdata[gc*4 +: 4];
                wire signed [7:0] product = a_lane * w_lane;
                always @(posedge clk) begin
                    if (state == S_IDLE && start) begin
                        chunk_accum[gr][gc] <= 12'sd0;
                        wide_accum[gr][gc] <= 24'sd0;
                    end else if (state == S_ACCUM) begin
                        chunk_accum[gr][gc] <= chunk_accum[gr][gc] + {{4{product[7]}}, product};
                    end else if (state == S_FOLD) begin
                        wide_accum[gr][gc] <= wide_accum[gr][gc] + {{12{chunk_accum[gr][gc][11]}}, chunk_accum[gr][gc]};
                        chunk_accum[gr][gc] <= 12'sd0;
                    end
                end
            end
        end
    endgenerate
endmodule
