physical-intuition/kimi-chip/experiments/x1/rtl/x1_y4_kimi.v

`timescale 1ns/1ps

// X1-Y4 keeps Y3's verified microarchitecture and closes the remaining
// post-route maximum-capacitance violations with physical-design margin.
// Keeping the logical design fixed makes this a controlled experiment: Y4
// measures electrical closure rather than mixing it with an RTL redesign.
module x1_y4_kimi (
    input  wire         clk,
    input  wire         rst_n,
    input  wire         start,
    input  wire [11:0]  k_dim,
    output wire         act_req,
    output wire [11:0]  act_addr,
    input  wire [63:0]  act_rdata,
    output wire         weight_req,
    output wire [11:0]  weight_addr,
    input  wire [63:0]  weight_rdata,
    output wire         out_we,
    output wire [13:0]  out_addr,
    output wire [23:0]  out_wdata,
    output wire         busy,
    output wire         done
);
    x1_y3_kimi core (
        .clk(clk), .rst_n(rst_n), .start(start), .k_dim(k_dim),
        .act_req(act_req), .act_addr(act_addr), .act_rdata(act_rdata),
        .weight_req(weight_req), .weight_addr(weight_addr),
        .weight_rdata(weight_rdata), .out_we(out_we), .out_addr(out_addr),
        .out_wdata(out_wdata), .busy(busy), .done(done)
    );
endmodule
