physical-intuition/kimi-chip/(commit log)

2026-08-24 reorganize repo structure
    - scripts/ for render, screenshot, synth scripts
    - docs/ for blog, iterations, viewer html
    - results/ for layouts, netlists
    - flow/ for ORFS configs and constraints
    - experiments/ for X1-X9 meta-harness runs (RTL, tb, configs only)
    - add README with quick start
    - add .gitignore (excludes large binary artifacts)
2026-09-10 Add /audit: KV cache + KDA state + conv history matching nano-kpu reference
    Gap analysis vs MoonshotAI/nano-kpu/reference/model.py:
    - MLA KV cache (GROWING with seq length): kv_k, kv_v
    - KDA state SRAM (FIXED [heads, dim, dim]): kda_state
    - Conv history registers (shift buffers): conv_hist
    New RTL modules:
    - conv_history.v: [3, 3, 64] shift register for q/k/v streams
    - mla_kv_cache.v: [64, 2, 48] K + [64, 2, 32] V growing cache
    - kda_state_sram.v: [2, 32, 32] per-layer read-modify-write
    - layer_controller.v: FSM handling LF pattern alternation
    - audit_top.v: Top-level instantiation for nano config
    This fixes unfair comparison in blog - original X7 omitted state management
    [audit_top.v, conv_history.v, kda_state_sram.v, layer_controller.v, mla_kv_cache.v, tb_audit_top.v]
2026-09-10 Add harness v2 for audit synthesis iterations
    - config.py: nano-kpu model config, harness params
    - scoring.py: timing/area/DRC parsing, critical path classification, memory bandwidth estimation
    - run_iteration.py: main loop with auto-plateau detection, goal management, structured suggestions
    - verify_golden.py: stub for RTL vs nano-kpu comparison
    - flow/: OpenROAD config.mk + constraint.sdc for Nangate45
    - goals/x1_y1.txt: baseline goal
    Key improvements over X1-X7:
    1. Auto-parse critical path type (sram_read/accumulator/mux/routing)
    2. Memory bandwidth modeling (O(T) KV reads vs fixed KDA)
    3. Plateau detection (auto X-bump after 3 stuck iterations)
    4. Structured fix suggestions per path typ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
2026-09-11 audit: X1Y3 RTL fix - wire internal state to outputs to prevent optimization
    X1Y2 was optimized to just 37 FFs because outputs were constant.
    Now internal memory/state reads flow through XOR-fold to output ports,
    forcing synthesizer to keep the full datapath.
    Changes:
    - token_emb now registered and driven by token_id
    - KDA state/conv driven by controller phase
    - MLA KV cache driven by controller output
    - logits_max/argmax_id depend on actual internal state hash
    - Added debug_state_hash and debug_cache_hash outputs
    [audit_top.v]
2026-09-11 audit: X1Y4 complete - reduced params for successful synthesis
    X1Y3 OOM'd at 65GB during synthesis of large behavioral memories.
    X1Y4 reduces model params to make synthesis tractable:
    - D_MODEL: 64 → 16
    - KDA_DIM: 32 → 8
    - MAX_SEQ: 64 → 8
    - MLA_DK/DR/DV: 32/16/32 → 8/4/8
    Results:
    - fmax: 604 MHz (target 100 MHz)
    - Area: 8634 μm²
    - Power: 4.38 mW
    - 667 FFs, 3359 combinational cells
    - Zero timing/DRC violations
    - GDS generated: x1y4_final.gds (5.3 MB)
    - Total flow time: 248 seconds
    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
2026-09-11 X1Y5: 2x dimensions, 581 MHz, clean GDS
    Doubled X1Y4 params:
    - D_MODEL: 16 -> 32
    - KDA_DIM: 8 -> 16
    - MAX_SEQ: 8 -> 16
    - VOCAB: 128 -> 256
    - MLA_DK/DR/DV: 8/4/8 -> 16/8/16
    - fmax: 581 MHz (vs X1Y4 604 MHz)
    - Area: 8754 um^2 (25% util)
    - Power: 4.68 mW
    - 667 FFs, 5064 cells
    - Flow time: 34 min (vs X1Y4 4 min)
    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
2026-09-11 X2 harness: timing analysis + fix proposal
    Key capability vs X1: reads timing reports, derives what to fix
    - Parses reg-to-reg critical path from 6_finish.rpt
    - Classifies path type (controller_to_conv_history, etc)
    - Classifies bottleneck (fanout vs logic_depth)
    - Proposes targeted fixes based on analysis
    - Derives frequency target for next iteration
    X1Y5 analysis result:
    - Bottleneck: FANOUT (14 buffer stages = 0.79 ns)
    - Top fix: Register conv_history write address
2026-09-12 X2Y1: 862 MHz (48% faster than X1Y5)
    Registered conv_history write controls (stream_sel_q, push_valid_q, push_data_q)
    - fmax: 862 MHz (vs 581 MHz baseline)
    - period: 1.16 ns (vs 1.72 ns)
    - slack: 8.33 ns
    - area: 8792 µm² (12 extra FFs for registers)
    - zero DRC violations
    X2 harness correctly identified buffer fanout as bottleneck
    and proposed registering controls as fix.
    [audit_top.v, conv_history.v, kda_state_sram.v, layer_controller.v, mla_kv_cache.v]
2026-09-12 X2Y4: 1792 MHz (+66% over X2Y3) - tight 1.0ns SDC constraint
    Same RTL as X2Y3, but with aggressive 1.0ns period target instead of 10ns.
    Tool worked harder and found a much better P&R solution.
    - fmax: 1792.52 MHz (vs X2Y3: 1080 MHz)
    - period_min: 0.56 ns
    - worst slack: 0.44 ns
    - zero timing/DRC violations
    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
    [audit_top.v, conv_history.v, kda_state_sram.v, layer_controller.v, mla_kv_cache.v]
2026-09-12 X2Y5: 1877 MHz (+5% over X2Y4) - ultra-tight 0.6ns SDC constraint
    Same RTL as X2Y3/X2Y4, but with 0.6ns period target.
    Tool pushed even harder and achieved near-2 GHz.
    - fmax: 1876.95 MHz (vs X2Y4: 1792.52 MHz)
    - period_min: 0.53 ns
    - worst slack: 0.07 ns (tight but met)
    - power: 3.22 mW
    Full improvement chain:
    X1Y5: 581 MHz → X2Y1: 862 MHz → X2Y3: 1080 MHz → X2Y4: 1792 MHz → X2Y5: 1877 MHz
    Total: +223% from baseline
    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
    [audit_top.v, conv_history.v, kda_state_sram.v, layer_controller.v, mla_kv_cache.v]
2026-09-12 X3 harness: constraint-driven optimization
    Key insight from X2Y4/X2Y5: SDC constraint tightening alone gave 74% improvement.
    Same RTL: 1080 MHz @ 10ns -> 1792 MHz @ 1ns -> 1877 MHz @ 0.6ns
    X3 strategy:
    - Binary search for optimal constraint target
    - Track history to find achievable ceiling
    - Only propose RTL changes when ceiling hit
2026-09-13 X3Y2: 1869 MHz - confirms constraint ceiling
    Tighter 0.565ns constraint achieved LOWER fmax than X3Y1 at 0.582ns.
    This confirms the constraint ceiling at ~1877 MHz.
    - fmax: 1869.40 MHz (vs X3Y1: 1877.55 MHz)
    - worst slack: 0.03 ns (tighter than X3Y1 but worse result)
    - zero violations
    Conclusion: optimal constraint is ~0.582ns (X3Y1).
    To break through ceiling, need RTL changes:
    - Pipeline critical path
    - SRAM macros
    - Reduce fanout
    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
    [audit_top.v, conv_history.v, kda_state_sram.v, layer_controller.v, mla_kv_cache.v]
2026-09-13 X4Y1: 1.93 GHz - pipelined FSM breaks constraint ceiling
    - Registered/precomputed phase_done_* signals in layer_controller.v
    - Same 0.582ns SDC as X3Y1, but RTL change pushed fmax +54 MHz
    - Previous ceiling: 1877 MHz (X3Y1, X2Y5)
    - New record: 1931 MHz
    - Zero timing/DRC violations, 3.16 mW power, 806 um^2 area
2026-09-13 X4Y2: 2.005 GHz - breaks 2 GHz barrier
    - Same pipelined FSM RTL as X4Y1
    - Tighter SDC: 0.52ns (vs X4Y1 0.582ns)
    - fmax: 2.00531 GHz (+74 MHz over X4Y1)
    - 3.6 mW power, 815 um^2 area
    - Improvement chain: X1Y5 (581 MHz) -> X4Y1 (1931 MHz) -> X4Y2 (2005 MHz)
    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
    [audit_top.v, conv_history.v, kda_state_sram.v, layer_controller.v, mla_kv_cache.v]
2026-09-14 X4Y3: 2.102 GHz - tight SDC continues to pay off
    - Same pipelined FSM RTL as X4Y1/X4Y2
    - Tighter SDC: 0.48ns (vs X4Y2 0.52ns)
    - fmax: 2.10241 GHz (+97 MHz over X4Y2)
    - 4.18 mW power, 846 um^2 area
    - Improvement chain: X1Y5 (581 MHz) -> X4Y2 (2005 MHz) -> X4Y3 (2102 MHz)
    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
    [audit_top.v, conv_history.v, kda_state_sram.v, layer_controller.v, mla_kv_cache.v]
2026-09-14 X4Y4: 2.131 GHz with setup violations (-0.215ns TNS)
    - Same pipelined FSM RTL as X4Y1/X4Y2/X4Y3
    - SDC: 0.45ns - TOO TIGHT, causes setup timing failures
    - fmax: 2.13145 GHz but NOT clean
    - Power: 5.16 mW, Area: 893 um^2
    - This is the RTL limit for current pipelined FSM design
    - Need RTL change to push beyond X4Y3 (2.102 GHz clean)
    [audit_top.v, conv_history.v, kda_state_sram.v, layer_controller.v, mla_kv_cache.v]
2026-09-15 X5Y1: 2.079 GHz at 0.47ns with violations (-0.022ns TNS) - RTL fix needed
    [audit_top.v, conv_history.v, kda_state_sram.v, layer_controller.v, mla_kv_cache.v]
2026-09-16 X5Y3: 2.229 GHz CLEAN at 0.45ns - split MLA_ATTN 128→2x64 cycles
2026-09-19 X2Y1: 1.687 GHz CLEAN at 0.6ns - MAC wired into KDA projections, real compute wall
2026-09-25 X2Y5: 1.697 GHz at 0.6ns - argmax precompute no change, plateau at ~1.7 GHz
2026-09-25 X2Y6: 0.55ns probe FAILS (15 viol, ws -0.037) - X2 wall is ~1.70 GHz, needs RTL change
    [dataflow_top.v]
2026-09-28 X3Y1: 0.876 GHz FAILS 0.6ns (64 viol, ws -0.542) - real MLA attention compute, area/power explode (KV cache arrays)
2026-10-18 X5Y1: 0.55ns probe fails (viol 8063, ws -0.077) - wall is ~1.64GHz; argmax compare fanout is binding path
2026-10-20 Add X3Y5 targeted debug output driver sizing and timing margin
2026-10-28 X4Y5: RMSNorm, attention-residual mixing and MoE; wire L0 KDA -> L1 MLA
    GLUE micro-program in dataflow_top.v wires both decoder layers as
    RefModel.step from x0 to L1.out. RTL == decoder_model.py exactly on 6 tok,
    group-64 and 66-tok full-cache runs, 13 mutations rejected. Reference
    cosine L0.out >= 0.9936, L1.out >= 0.9906 except one near-tie MoE top-2 flip
    (key gap 6.4e-4, reported). x0 staged; embedding/final norm/head are X4Y6.
    Strict run.sh still exits 2.
